zeynabalimpasa-web/Denemeler/cad/drone/teknik_resim/drone_teknik_resim.pdf

## ÖN GÖRÜNÜŞ

### gövde t=3±0.1

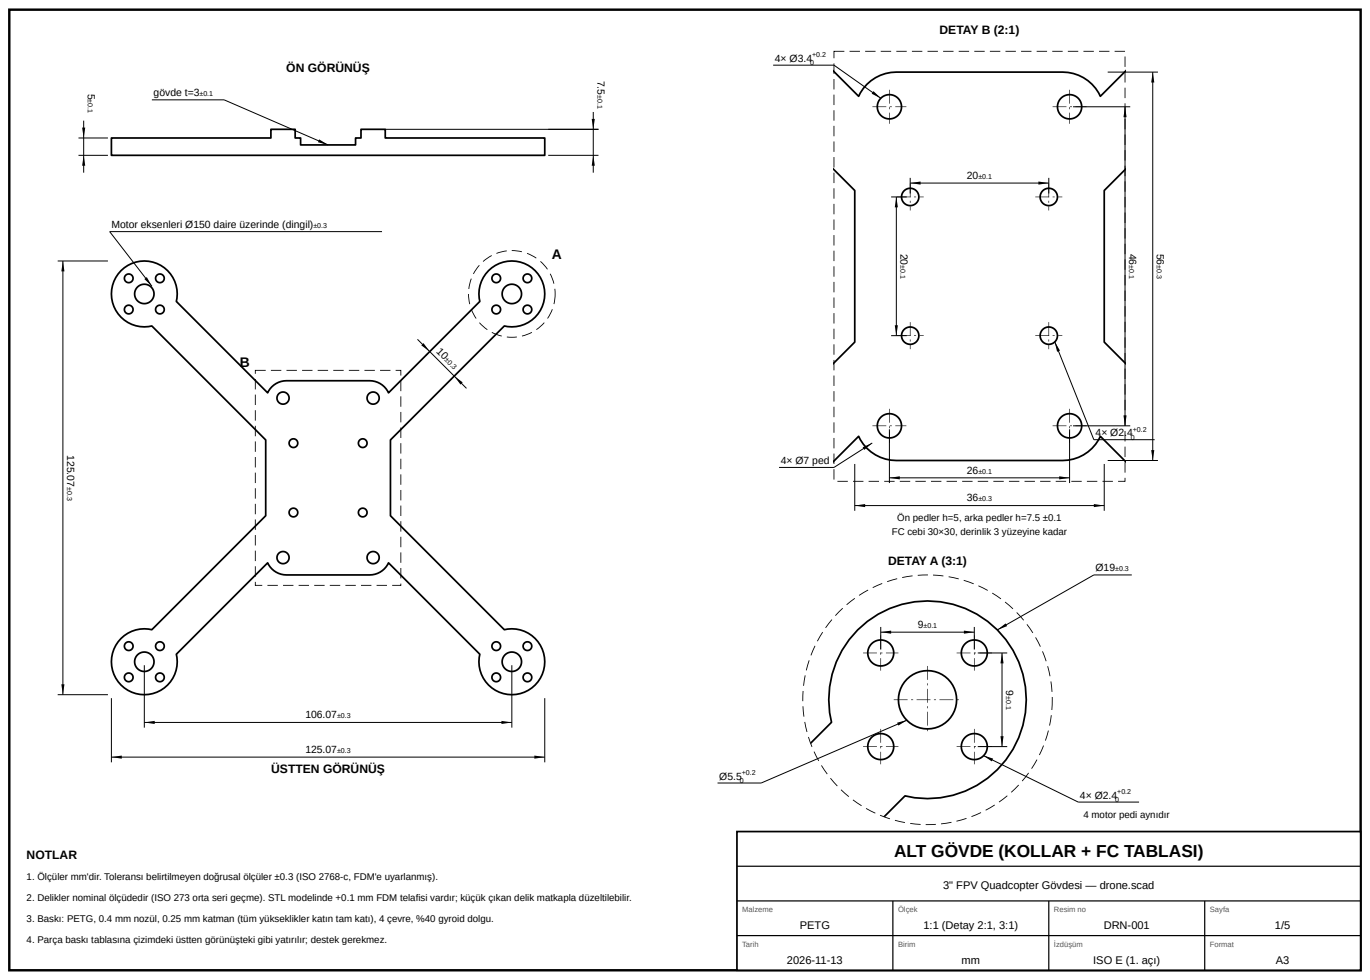
[picture p1: page 1]
ÜSTTEN GÖRÜNÜŞ; DETAY B (2:1); 4× Ø7 ped; DETAY A (3:1); 4 motor pedi aynıdır; Malzeme; PETG; Ölçek; 1:1 (Detay 2:1, 3:1); Resim no; DRN-001; Sayfa; Tarih; Birim; İzdüşüm; ISO E (1. açı); Format; NOTLAR

Motor eksenleri Ø150 daire üzerinde (dingil)±0.3

Ön pedler h=5, arka pedler h=7.5 ±0.1
FC cebi 30×30, derinlik 3 yüzeyine kadar

ALT GÖVDE (KOLLAR + FC TABLASI)

1. Ölçüler mm'dir. Toleransı belirtilmeyen doğrusal ölçüler ±0.3 (ISO 2768-c, FDM'e uyarlanmış).
2. Delikler nominal ölçüdedir (ISO 273 orta seri geçme). STL modelinde +0.1 mm FDM telafisi vardır; küçük çıkan delik matkapla düzeltilebilir.
3. Baskı: PETG, 0.4 mm nozül, 0.25 mm katman (tüm yükseklikler katın tam katı), 4 çevre, %40 gyroid dolgu.
4. Parça baskı tablasına çizimdeki üstten görünüşteki gibi yatırılır; destek gerekmez.

3" FPV Quadcopter Gövdesi — drone.scad

## ÖN GÖRÜNÜŞ

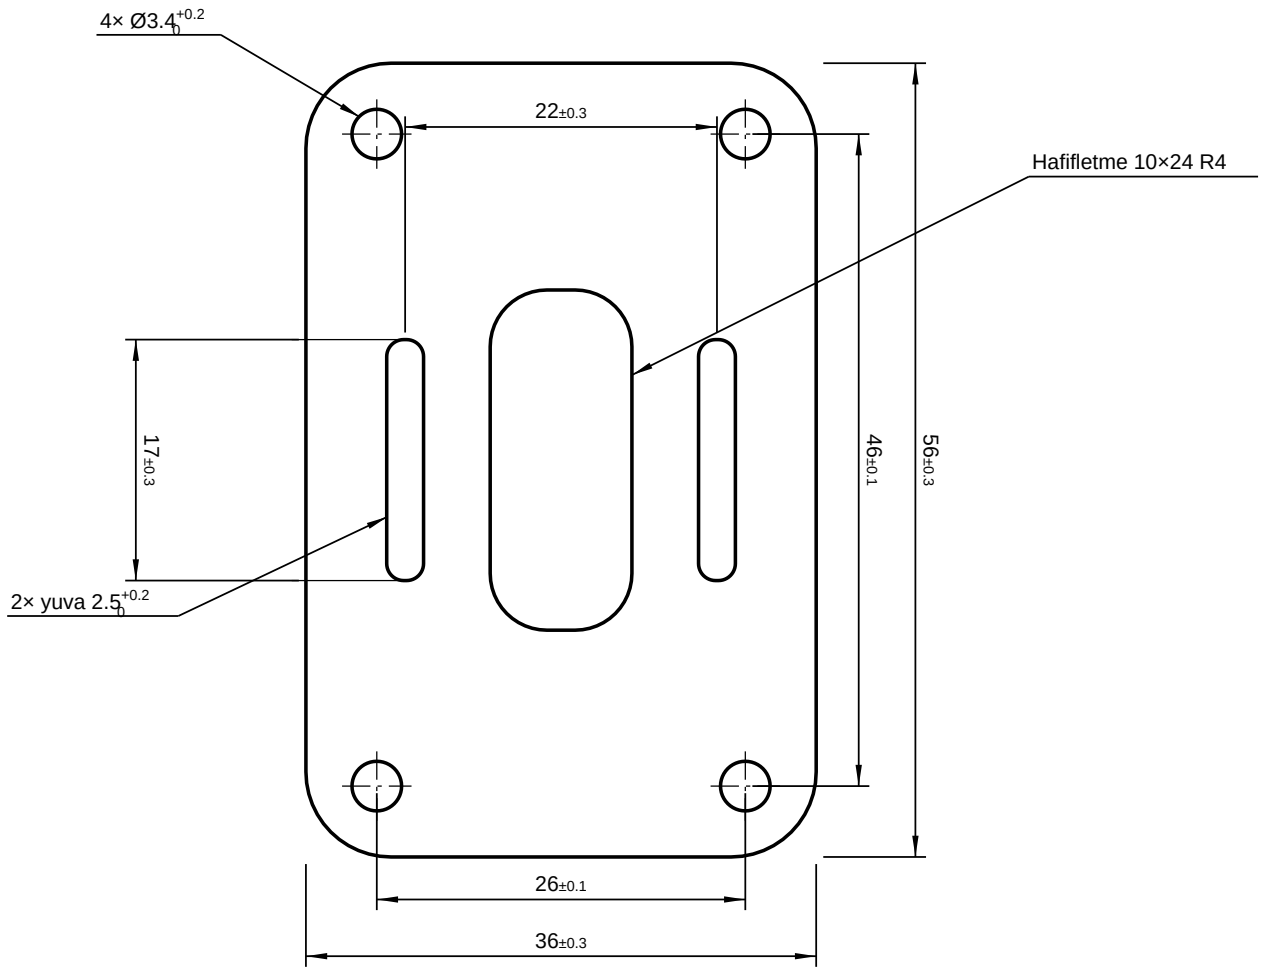
[picture p2: figure]
2× yuva 2.5; Hafifletme 10×24 R4

## ÜSTTEN GÖRÜNÜŞ

2.5±0.1

Batarya kayışı yuvaları 15 mm kayış içindir.

### Direk deseni (26×46) alt gövde ve kamera

tutucu ile ortak fonksiyonel ölçüdür.

Dış köşe yarıçapı R6.

# ÜST PLAKA (BATARYA PLAKASI)

## 3" FPV Quadcopter Gövdesi — drone.scad

Malzeme

Ölçek
2:1

Resim no

Sayfa

## NOTLAR

1. Ölçüler mm'dir. Toleransı belirtilmeyen doğrusal ölçüler ±0.3 (ISO 2768-c, FDM'e uyarlanmış).
2. Delikler nominal ölçüdedir (ISO 273 orta seri geçme). STL modelinde +0.1 mm FDM telafisi vardır; küçük çıkan delik matkapla düzeltilebilir.

ÖN GÖRÜNÜŞ | SOLDAN GÖRÜNÜŞ

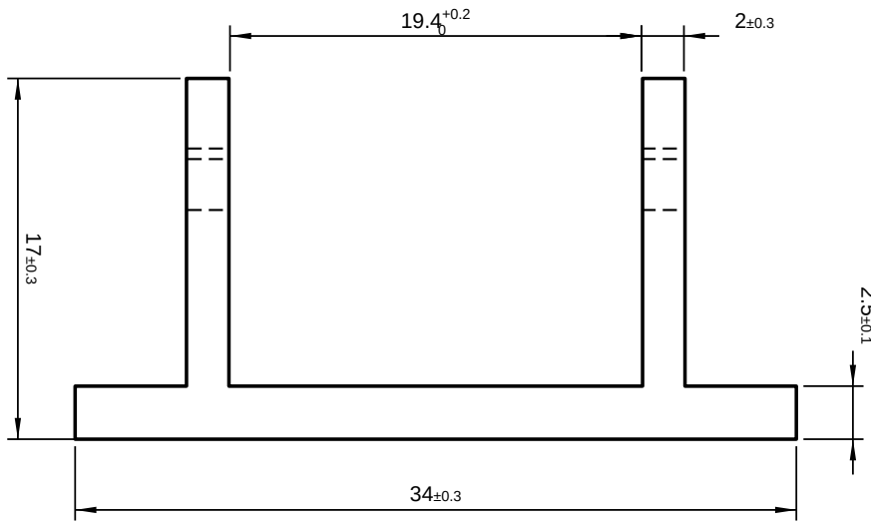
[picture p3: figure]
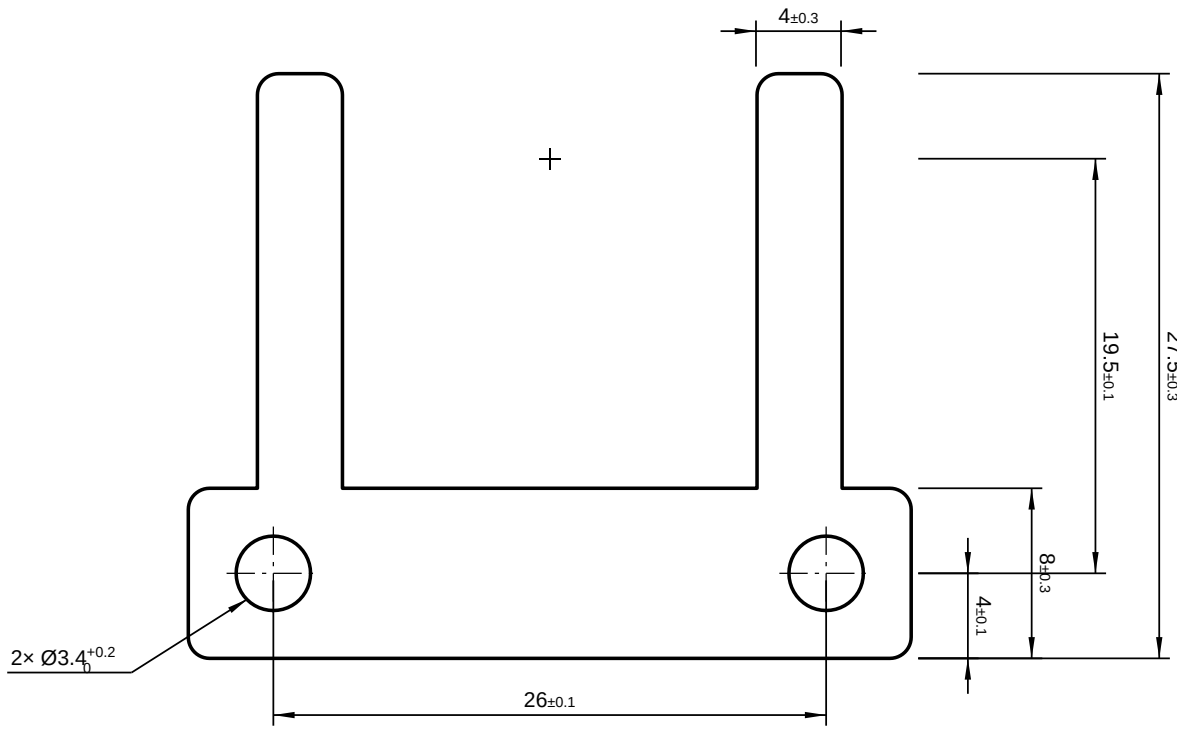
[picture p4: figure]

## ÜSTTEN GÖRÜNÜŞ

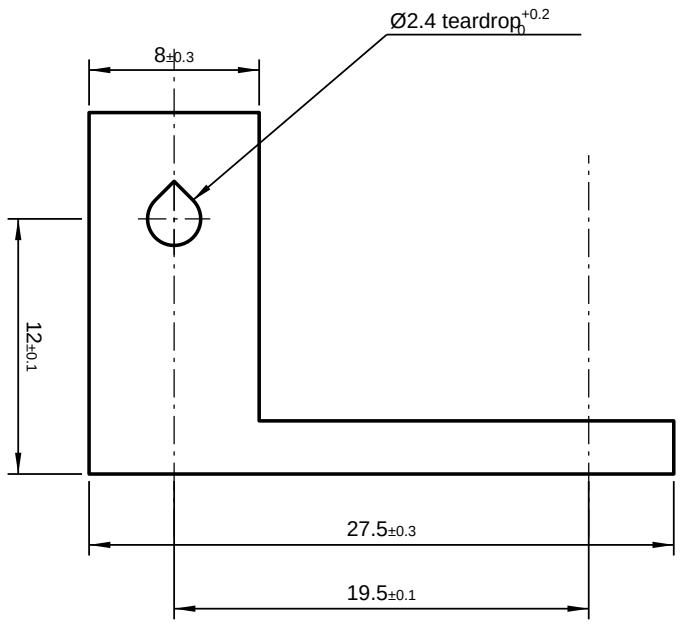
[picture p5: figure]
Ø2.4 teardrop

2.5±0.1

27.5±0.3

### Kamera yuvası 19.4 +0.2/0 ↔ kamera 19 ±0.1

→ boşluklu geçme, boşluk 0.3…0.7 mm (Z3).

### Kamera ekseni direk deliklerinden 19.5 mm önde ve taban

### U biçimlidir (kamera altı açık): kamera 0–40° eğimde

tabana ve üst plakaya çarpmaz (K1, DRN-005).

### Yan delikler destek gerektirmeyen teardrop biçimindedir

(sivri uç yukarı, 45°). Dış dikey köşeler R1.

# FPV KAMERA TUTUCU

## 3" FPV Quadcopter Gövdesi — drone.scad

Malzeme

Ölçek
3:1

Resim no

Sayfa

## NOTLAR

1. Ölçüler mm'dir. Toleransı belirtilmeyen doğrusal ölçüler ±0.3 (ISO 2768-c, FDM'e uyarlanmış).
2. Delikler nominal ölçüdedir (ISO 273 orta seri geçme). STL modelinde +0.1 mm FDM telafisi vardır; küçük çıkan delik matkapla düzeltilebilir.

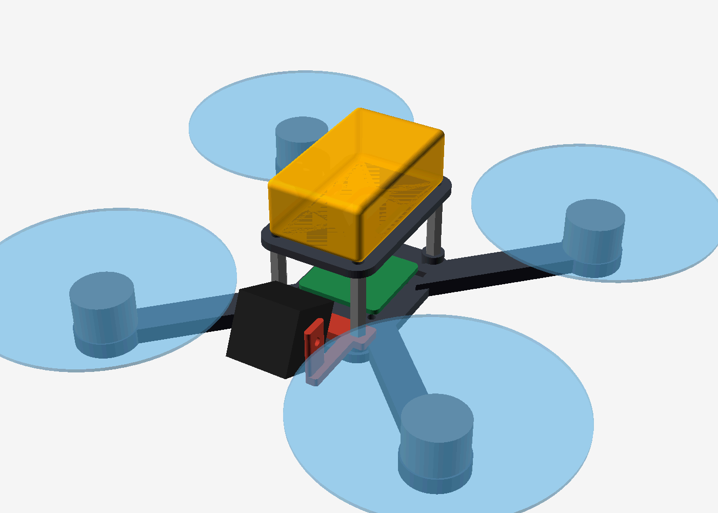
[picture p6: figure]

### MONTAJ (izometrik, ölçeksiz — motor/pervane/batarya temsilidir)

## PARÇA LİSTESİ

No | Parça | Malzeme / Standart | Adet
1 | Alt gövde | PETG baskı (DRN-001) | 1
2 | Üst plaka | PETG baskı (DRN-002) | 1
3 | Kamera tutucu | PETG baskı (DRN-003) | 1
4 | Direk M3×22 (dişi-dişi) | Alüminyum, ticari | 4
5 | Vida M3×12 (alt) | ISO 7380, çelik (bkz. Z5) | 4
6 | Vida M3×6 (üst) | ISO 7380, çelik | 4
7 | Motor vidası M2×7 | ISO 7380 (sargıya değmemeli) | 16
8 | Kamera vidası M2×4 | Kamera ile birlikte | 2
9 | FC montaj seti 20×20 M2 | Silikon sönümleyicili | 1
10 | Batarya kayışı 15 mm | Ticari | 1

## TOLERANS ANALİZİ ÖZETİ (ayrıntı: DRN-005)

Kod | Zincir / kontrol | Sonuç (WC veya MC)
Z1 | FC yığını – üst plaka boşluğu | 10.50 … 12.50 mm | ✓
Z2 | Üst plaka düzlemliği (ön − arka direk) | -0.70 … 0.70 mm | ✓
Z3 | Kamera yuvası yan boşluğu | 0.30 … 0.70 mm | ✓
Z4 | Motor vidası diş boyu (M2×7) | 1.61 … 2.39 mm | ✓
Z5a | Alt direk vidası diş boyu (M3×10, mevcut) | 2.01 … 2.99 mm | ✗
Z5b | Alt direk vidası diş boyu (M3×12, öneri) | 3.95 … 5.05 mm | ✓
Z6 | Üst direk vidası diş boyu (M3×6) | 3.11 … 3.89 mm | ✓
P1 | Direk delik hizası (2B, M3) | marj ≥ 0.14 mm (WC) | ✓
K1 | Eski tutucu (eksen y=7, dolu taban) | min boşluk -1.25 mm | ✗
K1 | Yeni tutucu (eksen y=19.5, U taban) | min boşluk 3.62 mm | ✓

✗ işaretli satırlar eski/değiştirilen tasarımdır; parça listesi ve kamera tutucu düzeltilmiştir.

## TASARIM KONTROLLERİ (drone.scad çıktısı)

Dingil: 150 mm, ayak izi (alt parça): 125 x 125 mm

Komşu pervane boşluğu: 29.87 mm ✓

Pervane–gövde boşluğu: 4.96 mm ✓

Kol konsol boyu: 50 mm, maks itkide uç sehim: 0.78 mm ✓

Kol kök gerilmesi: 4.76 MPa (akma 50 MPa, emniyet 11) ✓

Motor pedi et kalınlığı: 1.94 mm (FDM min 1.2)

Tahmini gövde kütlesi: ~40 g

── Tolerans analizi ──

Delik hizası M3: izin verilen çap. konum tol. 0.4 mm, desen ±0.1 → 0.28 mm ✓

Delik hizası M2: izin 0.4 mm, gerçek 0.28 mm ✓

Kamera geçmesi: yuva 19.4 +0.2/0, kamera 19 ±0.1 → boşluk 0.3…0.7 mm ✓ (boşluklu geçme)

Kamera dönme dairesi – plaka ön kenarı: 1.06 mm ✓ (kamera her eğimde plakaların önünde)

Direk düzlem farkı: 0 ± 0.3 mm (WC) → üst plaka eğimi maks 0.37° ✓

Direk ekseni–kol ekseni: 7.07 mm (kol yarı gen. 5, direk ped yarıçapı 3.5) → pedler kolla birleşik, direk somunu ped üstünde oturur

# MONTAJ, PARÇA LİSTESİ, TOLERANS ANALİZİ

## 3" FPV Quadcopter Gövdesi — drone.scad

| Malzeme
—
| Ölçek
—
| | Resim no

Sayfa

## ÖZET (birim mm; WC = en kötü durum, RSS = √Σt², MC = 200 000 örnek Monte Carlo)

Kod | Zincir | Nom. | WC aralığı | RSS aralığı | MC μ ± 3σ | Şart | ppm | Cpk | Sonuç
Z1 | FC yığını – üst plaka boşluğu | 11.50 | 10.50 … 12.50 | 10.93 … 12.07 | 11.50 ± 0.57 | 2 … | 0 | 16.81 | ✓ uygun
Z2 | Üst plaka düzlemliği (ön − arka direk) | 0.00 | -0.70 … 0.70 | -0.33 … 0.33 | 0.00 ± 0.33 | -0.8 … 0.8 | 0 | 2.41 | ✓ uygun
Z3 | Kamera yuvası yan boşluğu | 0.40 | 0.30 … 0.70 | 0.36 … 0.64 | 0.50 ± 0.14 | 0.1 … 1 | 0 | 2.82 | ✓ uygun
Z4 | Motor vidası diş boyu (M2×7) | 2.00 | 1.61 … 2.39 | 1.69 … 2.31 | 2.00 ± 0.31 | 1.5 … 2.5 | 0 | 1.63 | ✓ uygun
Z5a | Alt direk vidası diş boyu (M3×10, mevcut) | 2.50 | 2.01 … 2.99 | 2.18 … 2.82 | 2.50 ± 0.32 | 3 … 6 | 1000000 | -1.55 | ✗ uygun değil
Z5b | Alt direk vidası diş boyu (M3×12, öneri) | 4.50 | 3.95 … 5.05 | 4.12 … 4.88 | 4.50 ± 0.38 | 3 … 6 | 0 | 3.99 | ✓ uygun
Z6 | Üst direk vidası diş boyu (M3×6) | 3.50 | 3.11 … 3.89 | 3.19 … 3.81 | 3.50 ± 0.31 | 3 … 6 | 0 | 1.63 | ✓ uygun
P1 | Direk delik hizası (2B, M3) — marj | 0.47 | min 0.14 | — | 0.50 ± 0.14 | ≥ 0 | 0 | — | ✓ uygun
K1 | Eski tutucu (eksen y=7, dolu taban) — min boşluk | -1.25 | — | — | -1.25 ± 0.05 | ≥ 0.3 | 1000000 | — | ✗ uygun değil
K1 | Yeni tutucu (eksen y=19.5, U taban) — min boşluk | 3.62 | — | — | 3.62 ± 0.23 | ≥ 0.3 | 0 | — | ✓ uygun

## BULGULAR VE ÖNERİLER

1. Alt direk vidası M3×10: diş boyu
2.01…2.99 mm < 3 mm (1·d) → UYGUN DEĞİL. M3×12 ile 3.95…5.05 mm → parça listesi güncellendi.
2. Eski kamera tutucu: kamera tabana
çarpıyor (-1.25 mm @ 14°). Yeni tutucuda
eksen 19.5 mm öne alındı, taban U yapıldı:
0–40° boyunca min 3.62 mm boşluk.
3. Z1 değişiminin %78'i FC/ESC yığınından; gövde toleransları kritik değil.
4. Z4 (motor vidası) en dar marjlı zincir: vida boyu payın %89'i. Pul eklemeyin; M2×8 kullanılırsa motor sargısına değer.

### Z1 — FC yığını – üst plaka boşluğu

en büyük katkı: FC/ESC yığını* (%78)
ALT 2
2.00 | 12.12 μ = 11.50 σ = 0.188

### Z2 — Üst plaka düzlemliği (ön − arka direk)

en büyük katkı: ön direk (%36)
ALT -0.8 | ÜST 0.8
-0.80 | 0.80 μ = 0.00 σ = 0.111

### Z3 — Kamera yuvası yan boşluğu

en büyük katkı: yuva genişliği (%50)
ALT 0.1 | ÜST 1
0.10 | 1.00 μ = 0.50 σ = 0.047

### Z4 — Motor vidası diş boyu (M2×7)

en büyük katkı: vida boyu M2×7 (%89)
ALT 1.5 | ÜST 2.5
1.50 | 2.50
μ = 2.00 σ = 0.102

### Z5a — Alt direk vidası diş boyu (M3×10, mevcut)

en büyük katkı: vida boyu M3×10 (%81)
ALT 3 | ÜST 6
2.14 | 6.00 μ = 2.50 σ = 0.108

### Z5b — Alt direk vidası diş boyu (M3×12, öneri)

en büyük katkı: vida boyu M3×12 (%86)
ALT 3 | ÜST 6
3.00 | 6.00 μ = 4.50 σ = 0.125

### Z6 — Üst direk vidası diş boyu (M3×6)

en büyük katkı: vida boyu M3×6 (%89)
ALT 3 | ÜST 6
3.00 | 6.00 μ = 3.50 σ = 0.102

### P1 — Direk delik hizası (2B, M3)

marj = izin verilen − gerçek sapma (en kötü delik) ALT 0

0.00 | 0.63 μ = 0.50 σ = 0.046

### K1 — Kamera eğim boşluğu (nominal)

En yakın engele uzaklık (mm) — eğim 0–40°; negatif = çarpışma

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
0° | 10° | 20° | 30° | 40° min boşluk 0.3

Eski tutucu
-1.25 mm @ 14° (taban)

Yeni tutucu
3.62 mm @ 40° (zemin)
Eski tutucu (eksen y=7, dolu taban) | Yeni tutucu (eksen y=19.5, U taban)

### VARSAYIMLAR (ticari parçalar)

FC/ESC yığını 15 ±0.5; vida boyu ISO 4759-1 js15 Motor diş derinliği 2.5; direk diş derinliği 6
Kamera 19×19×19 (lens hariç), delik ofseti ±0.2 Dağılım: ±t = ±3σ normal; tek yönlü tol. orta nokta * üretici verisiyle doğrulanmalı

# TOLERANS BİRİKMESİ ANALİZİ

## 3" FPV Quadcopter Gövdesi — drone.scad

Malzeme
—

Ölçek
—

Resim no

Sayfa
