zeynabalimpasa-web/Denemeler/cad/cikti/onizleme.png

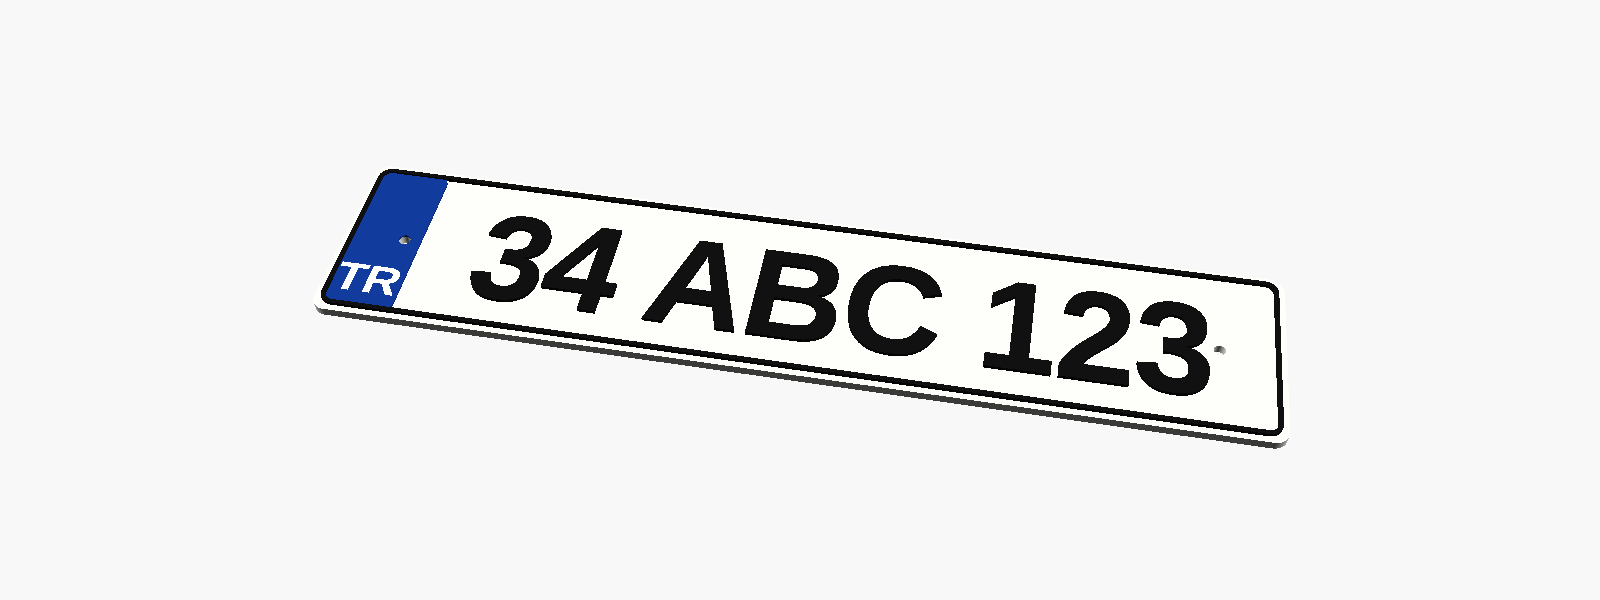
cad/cikti/onizleme.png
