zeynabalimpasa-web/Denemeler/cad/drone/cikti/alt_ustten.png

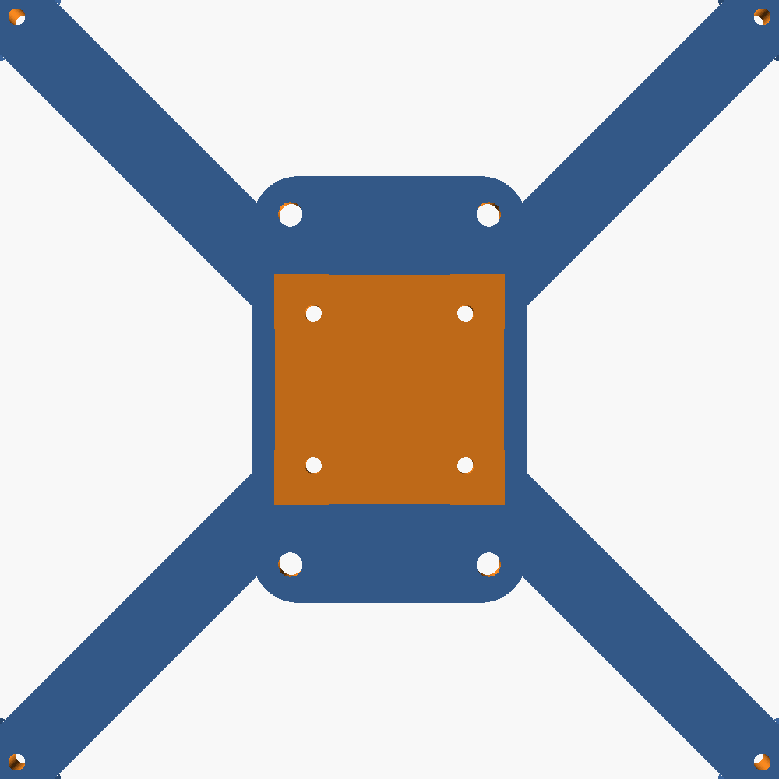
cad/drone/cikti/alt_ustten.png
