zeynabalimpasa-web/Denemeler/cad/drone/teknik_resim/DRN-001_alt_govde.png

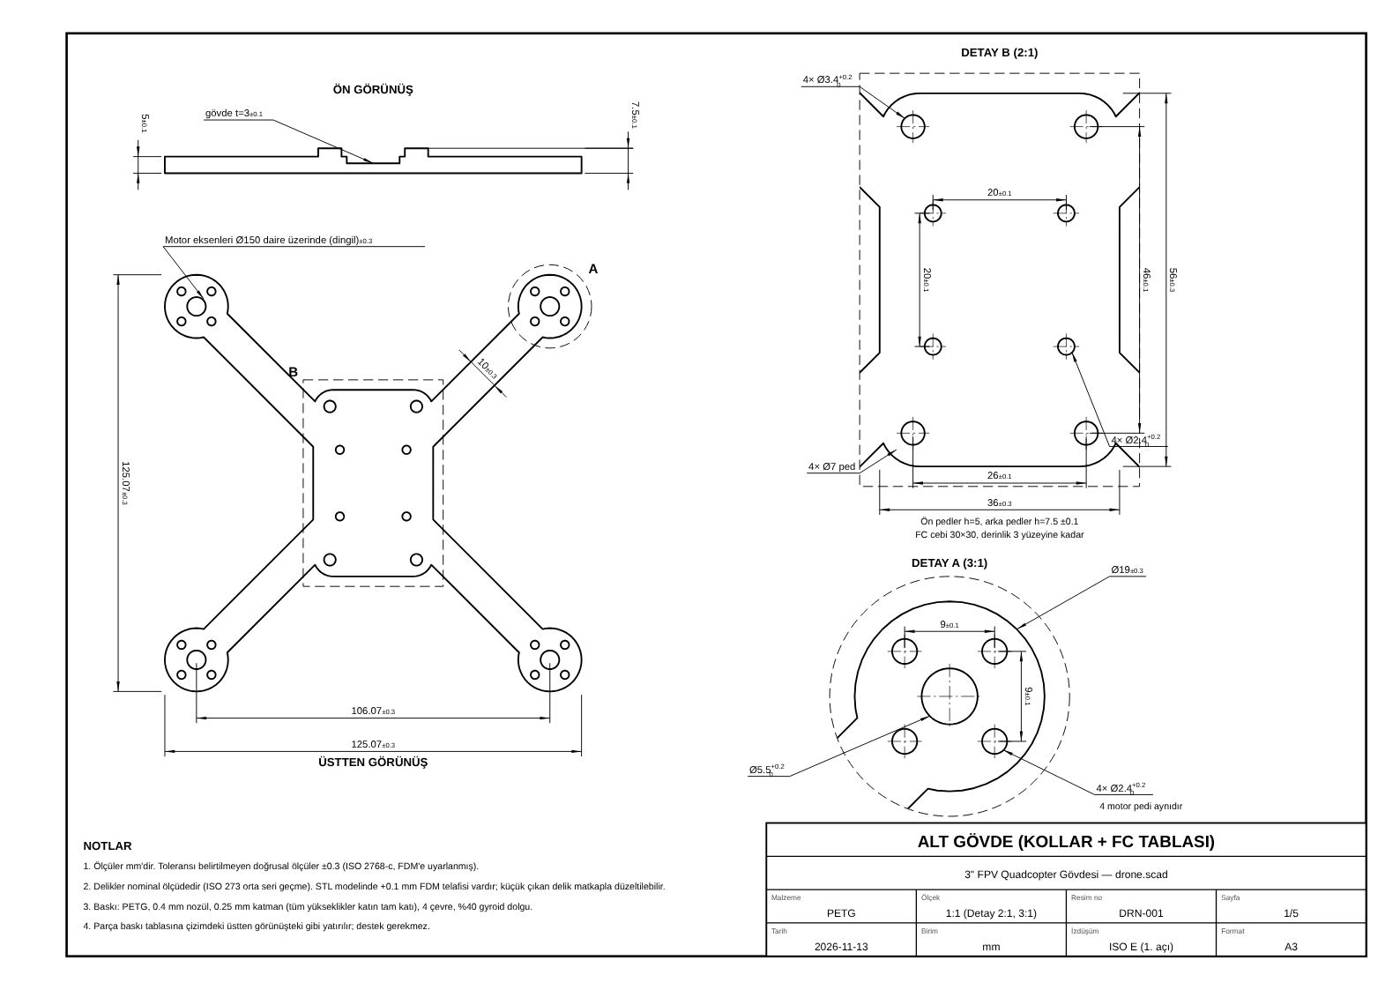
cad/drone/teknik_resim/DRN-001_alt_govde.png
