zeynabalimpasa-web/Denemeler/cad/drone/teknik_resim/DRN-002_ust_plaka.png

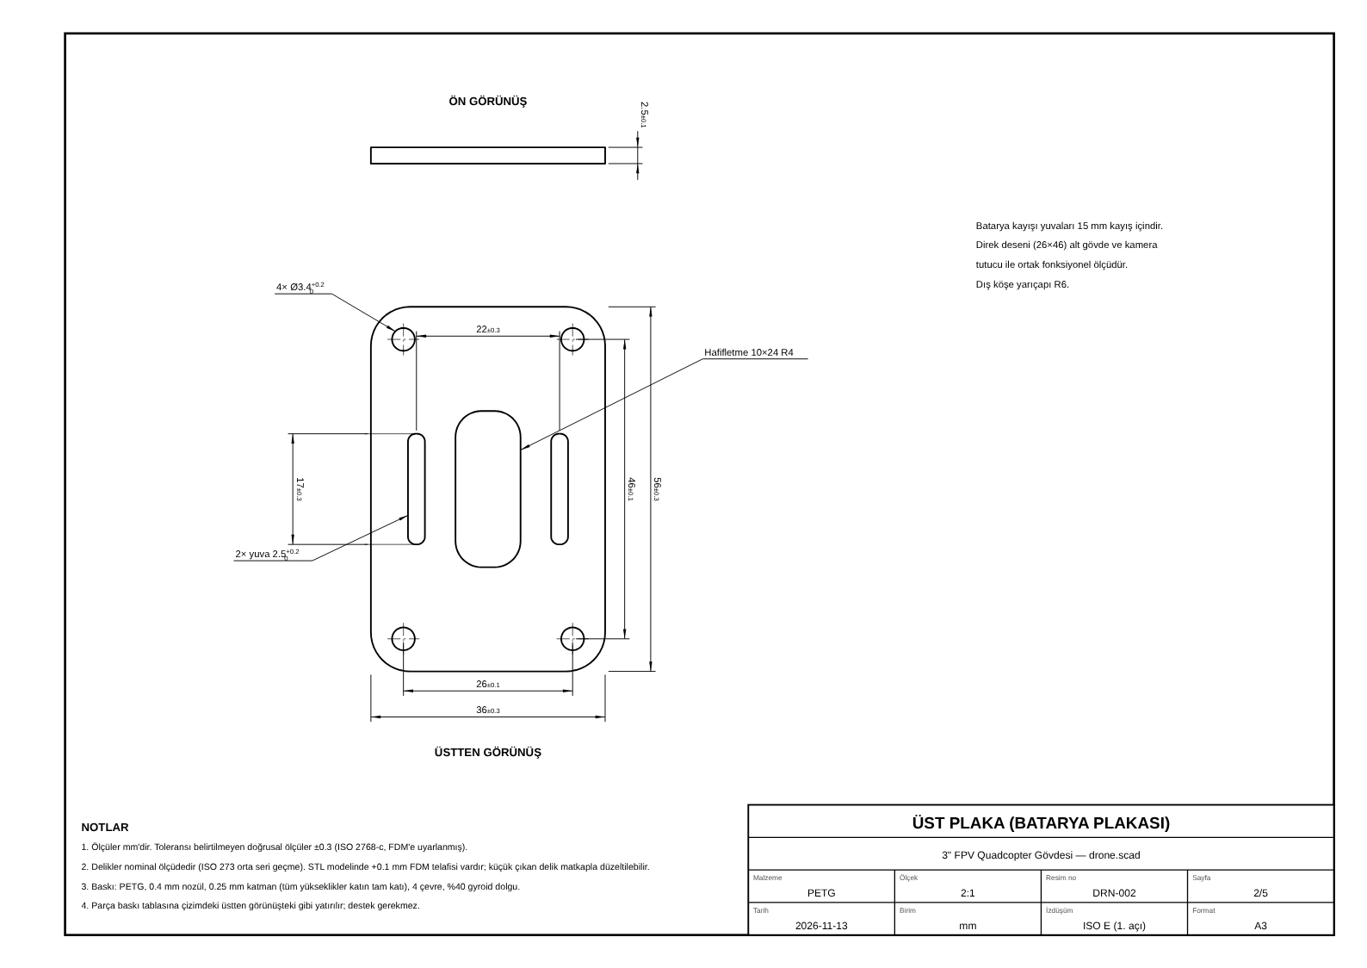
cad/drone/teknik_resim/DRN-002_ust_plaka.png
