zeynabalimpasa-web/Denemeler/cad/drone/teknik_resim/DRN-003_kamera_tutucu.png

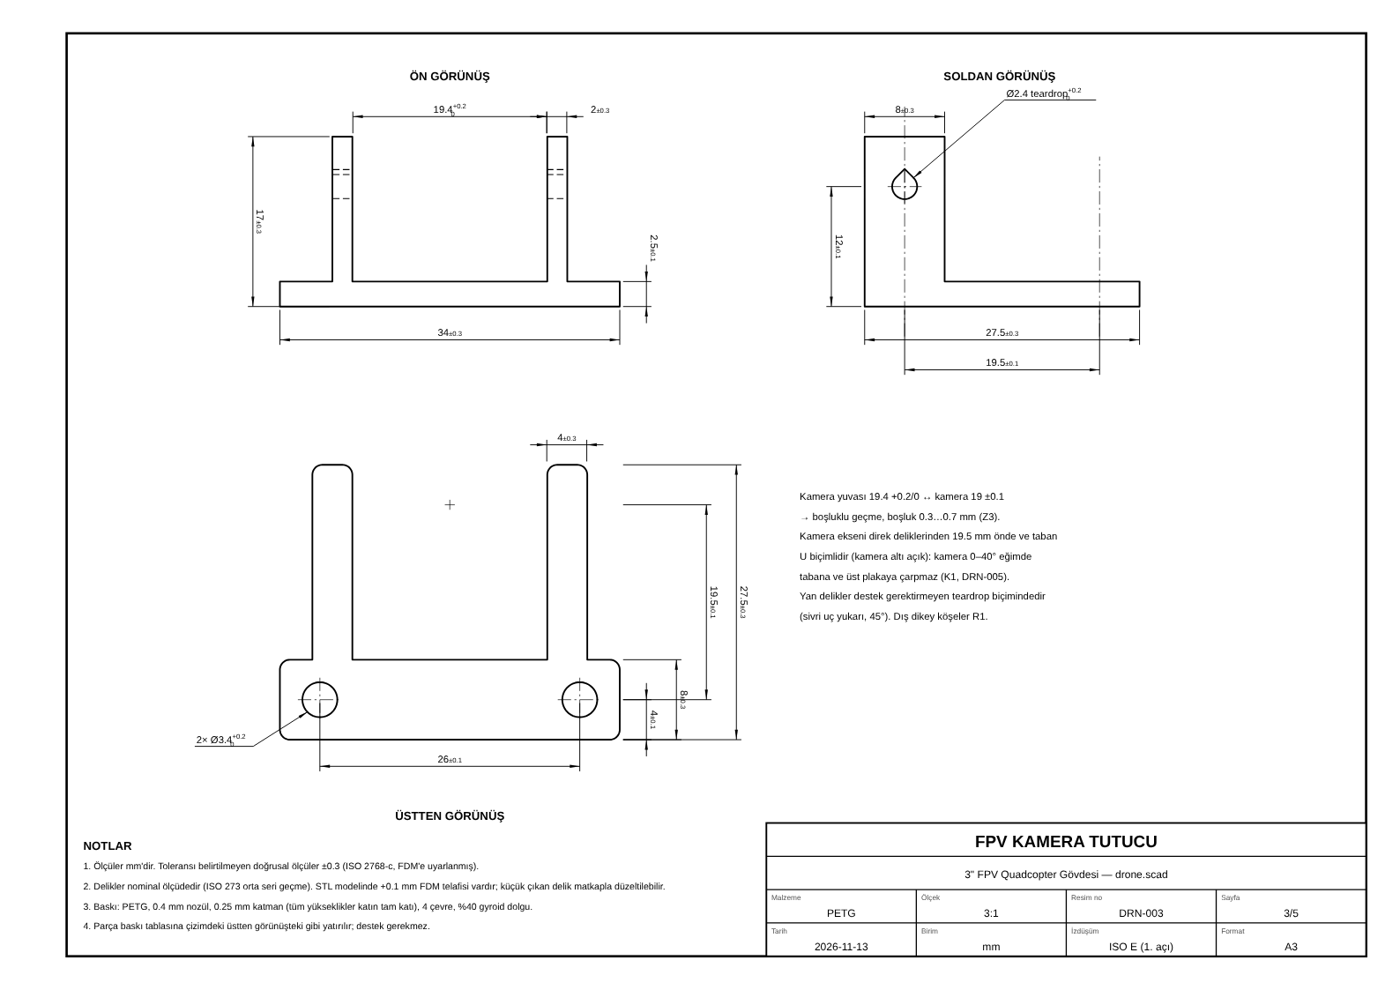
cad/drone/teknik_resim/DRN-003_kamera_tutucu.png
