zeynabalimpasa-web/Denemeler/cad/drone/teknik_resim/DRN-005_tolerans_analizi.png

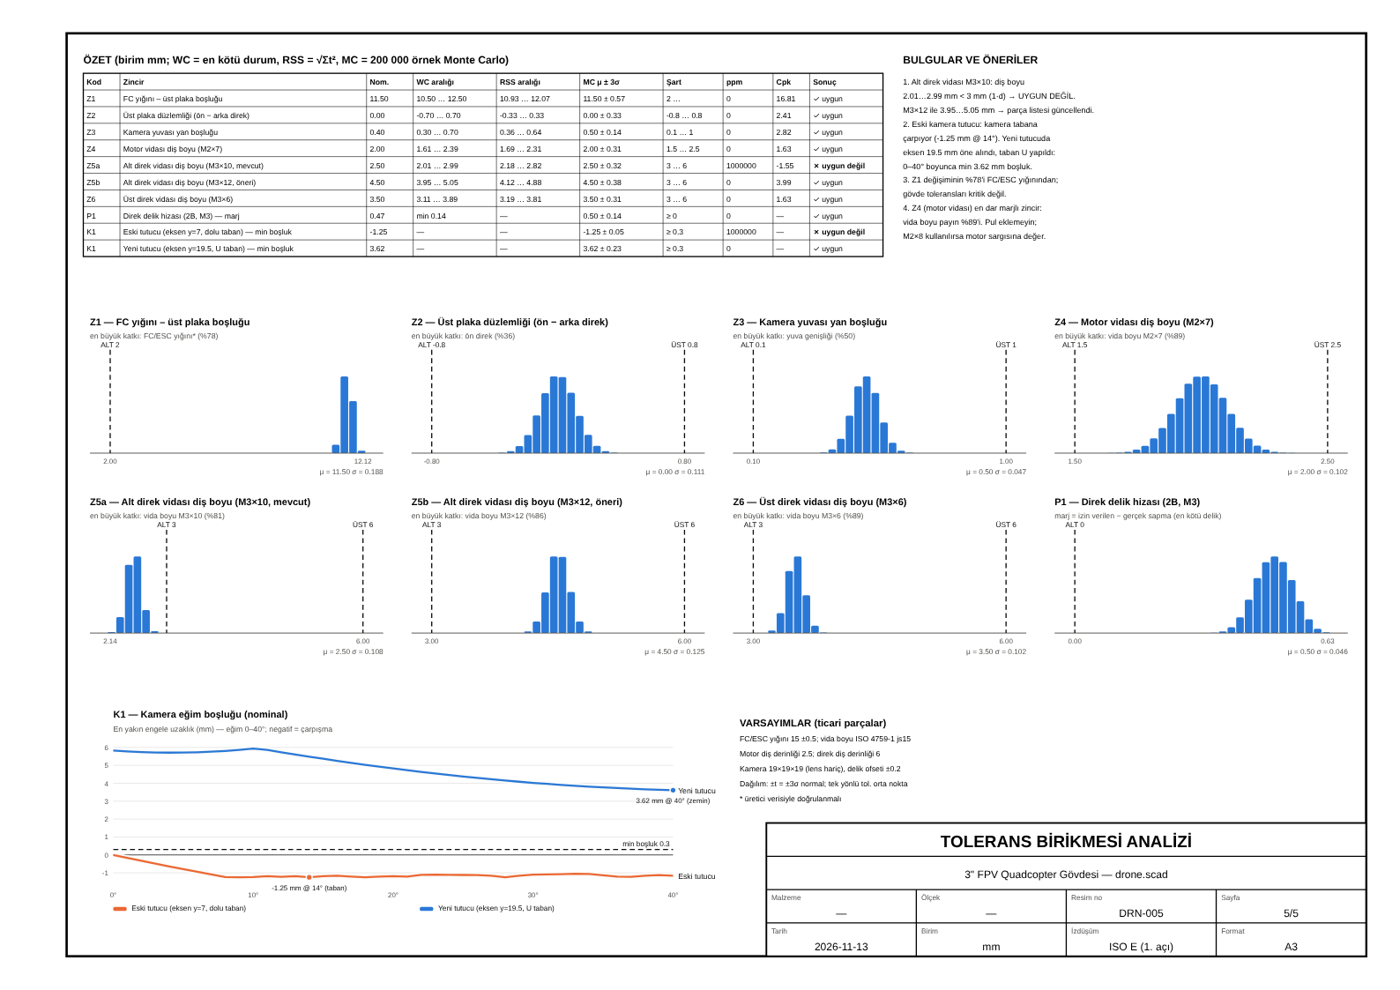
cad/drone/teknik_resim/DRN-005_tolerans_analizi.png
