zeynabalimpasa-web/Denemeler/cad/cikti/plaka_tr.stl

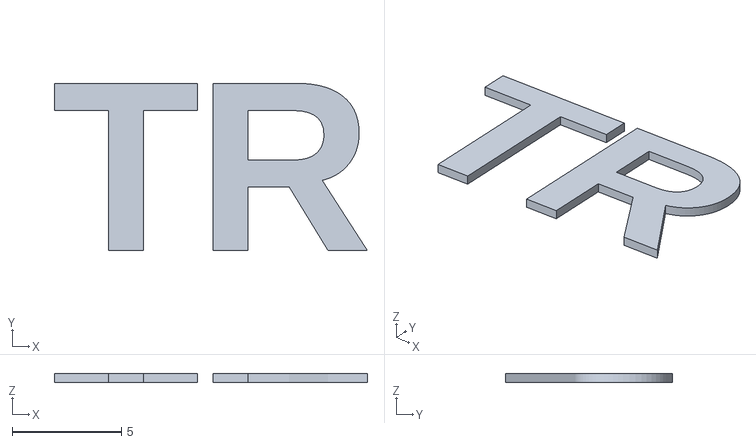
[picture p13: CAD file, 2026-11-13]
cad/cikti/plaka_tr.stl
14.3 x 7.64 x 0.4
