zeynabalimpasa-web/Denemeler/cad/drone/cikti/drone_alt.stl

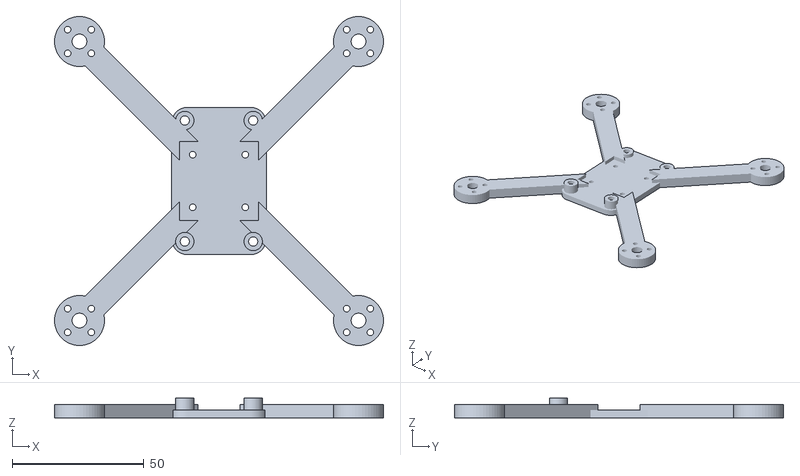
[picture p14: CAD file, 2026-11-13]
cad/drone/cikti/drone_alt.stl
125.1 x 125.1 x 7.50
