zeynabalimpasa-web/Denemeler/cad/cikti/plaka_mavi.stl

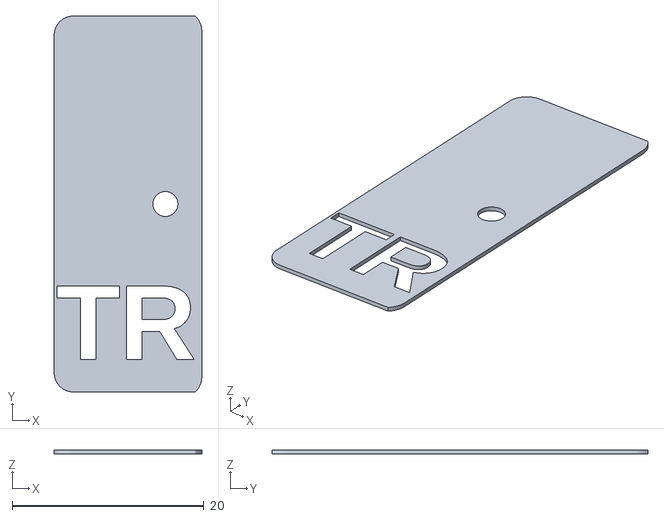
[picture p15: CAD file, 2026-11-13]
cad/cikti/plaka_mavi.stl
15.4 x 39.2 x 0.4
