zeynabalimpasa-web/Denemeler/cad/drone/cikti/drone_kamera.stl

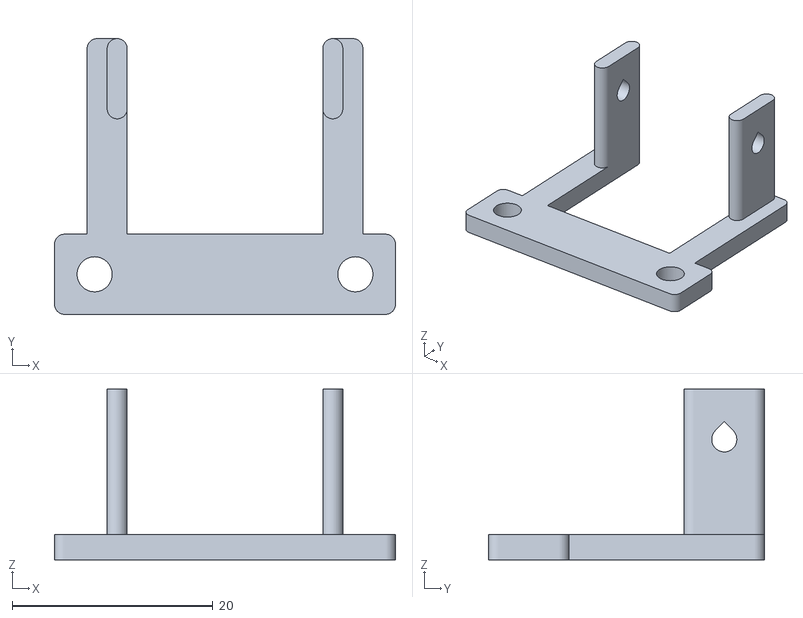
[picture p16: CAD file, 2026-11-13]
cad/drone/cikti/drone_kamera.stl
34.0 x 27.5 x 17.0
