zeynabalimpasa-web/Denemeler/cad/cikti/plaka_govde.stl

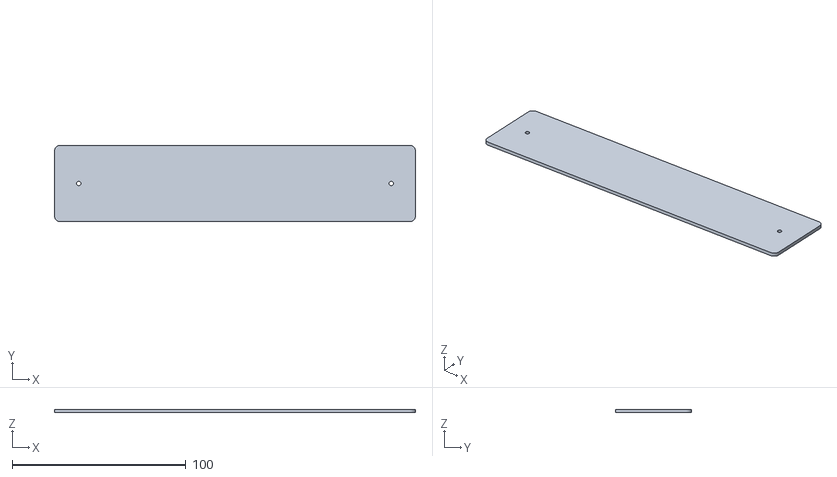
[picture p17: CAD file, 2026-11-13]
cad/cikti/plaka_govde.stl
208.0 x 44.0 x 2.00
