zeynabalimpasa-web/Denemeler/cad/drone/cikti/drone_ust.stl

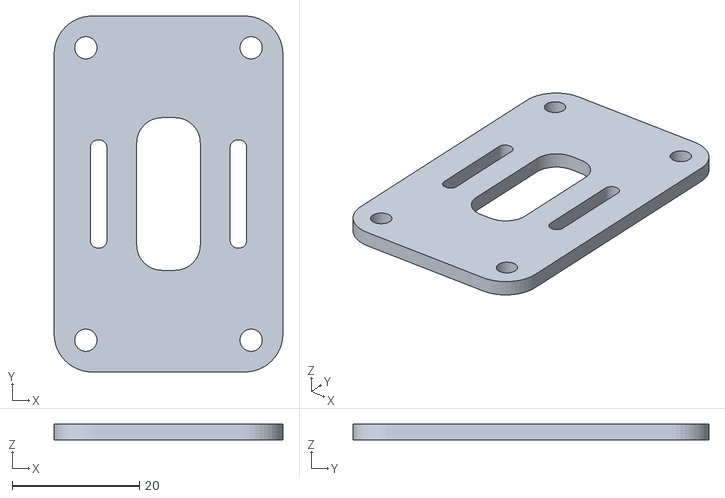
[picture p18: CAD file, 2026-11-13]
cad/drone/cikti/drone_ust.stl
36.0 x 56.0 x 2.50
