zeynabalimpasa-web/Denemeler/cad/cikti/plaka_siyah.stl

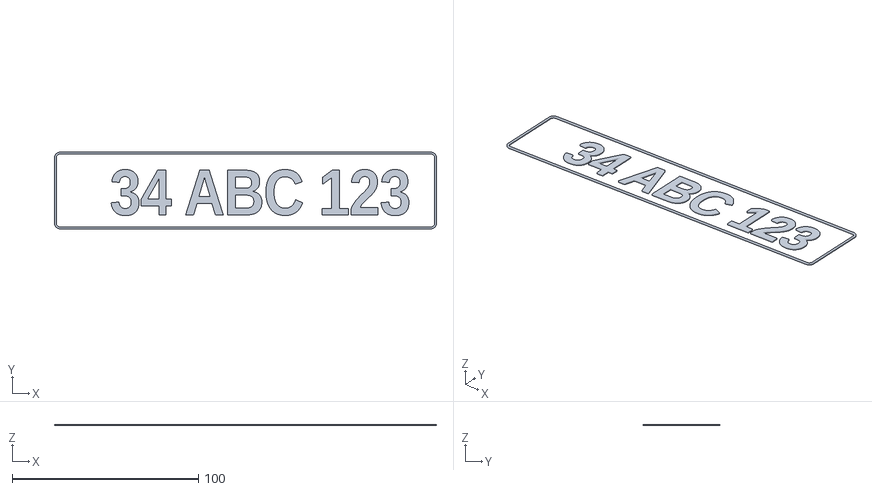
[picture p19: CAD file, 2026-11-13]
cad/cikti/plaka_siyah.stl
205.2 x 41.2 x 0.8
