zeynabalimpasa-web/Denemeler/cad/cikti/plaka_tek_renk.stl

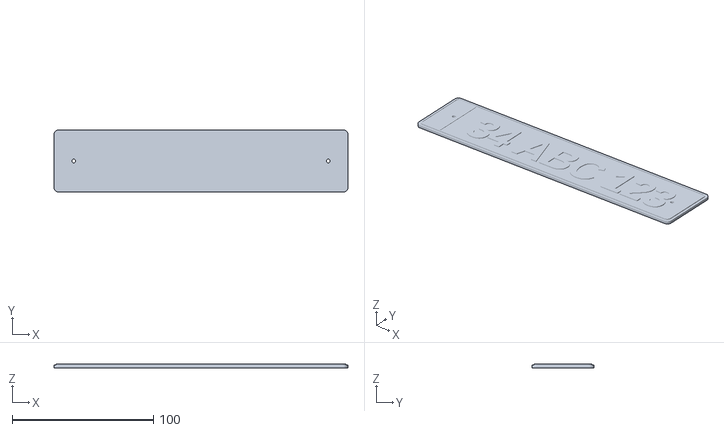
[picture p20: CAD file, 2026-11-13]
cad/cikti/plaka_tek_renk.stl
208.0 x 44.0 x 2.80
