zeynabalimpasa-web/Denemeler/cad/drone/teknik_resim/DRN-004_montaj_tolerans.png

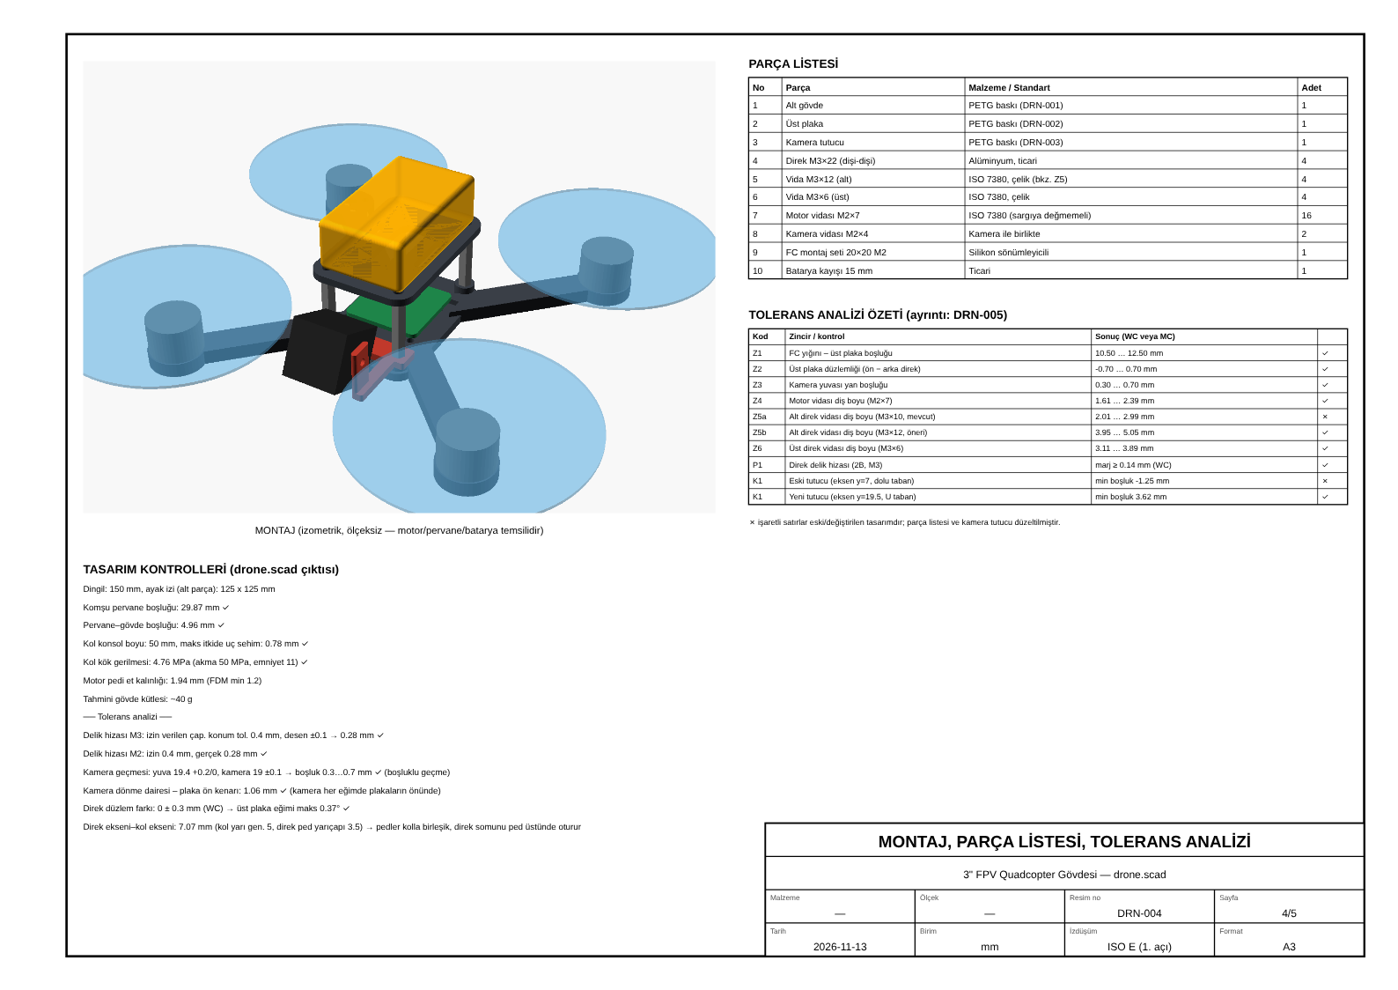
cad/drone/teknik_resim/DRN-004_montaj_tolerans.png
