zeynabalimpasa-web/Denemeler/(commit log)

2026-11-13 Plakanın 3D baskıya uygun OpenSCAD modelini ve STL çıktılarını ekle
    Claude-Session: https://claude.ai/code/session_01BVkHnHq7VNMoMGdrEPovur
    [plaka.scad, plaka_govde.stl, plaka_mavi.stl, plaka_siyah.stl, plaka_tek_renk.stl, plaka_tr.stl]
2026-11-13 3 inç FPV drone gövdesinin OpenSCAD modelini ve STL çıktılarını ekle
    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
    [drone.scad, drone_alt.stl, drone_kamera.stl, drone_ust.stl]
2026-11-13 Drone parçalarına tolerans/geçme analizi ve A3 teknik resimler ekle
    - ISO 273 geçme delikleri, FDM telafisi, desen/kalınlık toleransları
    - Tolerans zinciri kontrolleri (serbest bağlantı, kamera geçmesi, WC/RSS)
    - Direk pedleri: direklerin kola çarpması düzeltildi, üst plaka düz oturur
    - teknik_resim.py: ölçüleri modelden okuyup SVG/PDF/PNG çizim üretir
    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
    [drone.scad, drone_alt.stl, drone_kamera.stl, drone_ust.stl]
2026-11-13 Tolerans birikmesi analizi ekle (WC/RSS/Monte Carlo) ve bulguları düzelt
    - tolerans_analizi.py: 7 doğrusal zincir, 2B delik hizası ve kamera eğim
    boşluğu (Monte Carlo); A3 sayfa DRN-005
    - Kamera tutucu: kamera 0-40° eğimde tabana çarpıyordu; eksen 19.5 mm
    öne alındı, taban U biçimli yapıldı
    - Alt direk vidası M3x10 diş boyu yetersiz (2.5 < 3 mm) -> M3x12
    - Teknik resimler 5 sayfaya güncellendi
    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
    [drone.scad, drone_alt.stl, drone_kamera.stl]
